dariusur/SpectrumAnalyzer/SpectrumAnalyzer/SpectrumAnalyzer.runs/impl_1/.init_design.begin.rst

<?xml version="1.0"?>
<ProcessHandle Version="1" Minor="0">
    <Process Command=".planAhead." Owner="Darius" Host="DESKTOP-7B2FBLM" Pid="12524">
    </Process>
</ProcessHandle>
