dariusur/SpectrumAnalyzer/SpectrumAnalyzer/SpectrumAnalyzer.runs/dft_0_synth_1/.vivado.begin.rst

<?xml version="1.0"?>
<ProcessHandle Version="1" Minor="0">
    <Process Command="vivado.bat" Owner="Darius" Host="DESKTOP-7B2FBLM" Pid="7576" HostCore="16" HostMemory="014877265920">
    </Process>
</ProcessHandle>
