dariusur/SpectrumAnalyzer/SpectrumAnalyzer/SpectrumAnalyzer.gen/sources_1/ip/dft_0/doc/dft_v4_2_changelog.txt

2022.2:
 * Version 4.2 (Rev. 3)
 * No changes

2022.1.2:
 * Version 4.2 (Rev. 3)
 * No changes

2022.1.1:
 * Version 4.2 (Rev. 3)
 * No changes

2022.1:
 * Version 4.2 (Rev. 3)
 * General: Matlab demonstration smoke test updated. No change to core functionality.
 * General: changing RTL defaults to ensure faithful regeneration from XCI

2021.2.2:
 * Version 4.2 (Rev. 2)
 * No changes

2021.2.1:
 * Version 4.2 (Rev. 2)
 * No changes

2021.2:
 * Version 4.2 (Rev. 2)
 * No changes

2021.1.1:
 * Version 4.2 (Rev. 2)
 * No changes

2021.1:
 * Version 4.2 (Rev. 2)
 * Bug Fix: Fix power-on edge case
 * Bug Fix: Fix stale c model file causing issues in shared object file

2020.3:
 * Version 4.2 (Rev. 1)
 * No changes

2020.2.2:
 * Version 4.2 (Rev. 1)
 * No changes

2020.2.1:
 * Version 4.2 (Rev. 1)
 * No changes

2020.2:
 * Version 4.2 (Rev. 1)
 * Bug Fix: MEX wrapper did not support new point sizes.

2020.1.1:
 * Version 4.2
 * No changes

2020.1:
 * Version 4.2
 * General: Support added for larger point sizes 1440, 1500, 1620, 1728, 1800, 1920, 1944, 2160, 2304, 2400, 2592, 2700, 2880, 2916, 3000, 3072, 3240

2019.2.2:
 * Version 4.1 (Rev. 1)
 * No changes

2019.2.1:
 * Version 4.1 (Rev. 1)
 * No changes

2019.2:
 * Version 4.1 (Rev. 1)
 * No changes

2019.1.3:
 * Version 4.1 (Rev. 1)
 * No changes

2019.1.2:
 * Version 4.1 (Rev. 1)
 * No changes

2019.1.1:
 * Version 4.1 (Rev. 1)
 * No changes

2019.1:
 * Version 4.1 (Rev. 1)
 * Revision change in one or more subcores

2018.3.1:
 * Version 4.1
 * No changes

2018.3:
 * Version 4.1
 * General: Support added for point sizes 4, 8, 16, 20, 32, 40, 64, 80, 128, 256

2018.2:
 * Version 4.0 (Rev. 15)
 * No changes

2018.1:
 * Version 4.0 (Rev. 15)
 * Revision change in one or more subcores

2017.4:
 * Version 4.0 (Rev. 14)
 * No changes

2017.3:
 * Version 4.0 (Rev. 14)
 * General: Comment change in C model. No change to functionality
 * Revision change in one or more subcores

2017.2:
 * Version 4.0 (Rev. 13)
 * No changes

2017.1:
 * Version 4.0 (Rev. 13)
 * Worked around LSB mismatch for point sizes 768 and 1080 between C model and IP seen when simulating with Vivado Simulator or Cadence IES
 * Fixed bug in Matlab MEX wrapper which prevented simulation of 1536-point DFT

2016.4:
 * Version 4.0 (Rev. 12)
 * No changes

2016.3:
 * Version 4.0 (Rev. 12)
 * General: Support for Spartan7 devices
 * Revision change in one or more subcores

2016.2:
 * Version 4.0 (Rev. 11)
 * No changes

2016.1:
 * Version 4.0 (Rev. 11)
 * Fix in common c model utilities package for handling of arrays of real types in Matlab
 * Revision change in one or more subcores

2015.4.2:
 * Version 4.0 (Rev. 10)
 * No changes

2015.4.1:
 * Version 4.0 (Rev. 10)
 * No changes

2015.4:
 * Version 4.0 (Rev. 10)
 * Revision change in one or more subcores

2015.3:
 * Version 4.0 (Rev. 9)
 * IP revision number added to HDL module, library, and include file names, to support designs with both locked and upgraded IP instances
 * Worked around LSB mismatch between C model and IP seen when simulating with Vivado Simulator or Cadence IES
 * Revision change in one or more subcores

2015.2.1:
 * Version 4.0 (Rev. 8)
 * No changes

2015.2:
 * Version 4.0 (Rev. 8)
 * Re-phrased internal function to avoid Vivado Simulator elaboration error.  No functional changes.

2015.1:
 * Version 4.0 (Rev. 7)
 * Addition of Beta support for future devices
 * Supported devices and production status are now determined automatically, to simplify support for future devices
 * C models are no longer provided for 32-bit operating systems as Vivado has deprecated 32-bit OS support

2014.4.1:
 * Version 4.0 (Rev. 6)
 * No changes

2014.4:
 * Version 4.0 (Rev. 6)
 * Encrypted source files are concatenated together to reduce the number of files and to reduce simulator compile time
 * Enabled out-of-context clock frequency setting by adding FREQ_HZ parameter to clock interface aclk_intf

2014.3:
 * Version 4.0 (Rev. 5)
 * Reduce memory consumption of C model.

2014.2:
 * Version 4.0 (Rev. 4)
 * No changes

2014.1:
 * Version 4.0 (Rev. 4)
 * C models for Windows are compiled using Microsoft Visual Studio 2012
 * Support for obsolete Spartan devices removed from source code. Functionality of is unaffected.
 * Rephrasing of vhdl files. Functionality is unaffected.
 * Internal device family name change, no functional changes
 * Enable third party synthesis tools to read encrypted netlists (but not source HDL)
 * Support for Virtex Ultrascale devices at Pre-Production Status

2013.4:
 * Version 4.0 (Rev. 3)
 * Support for Kintex Ultrascale devices at Pre-Production Status

2013.3:
 * Version 4.0 (Rev. 2)
 * Internal standardization in source file delivery, does not change behavior
 * Support for Automotive Artix-7, Automotive Zynq, Defense Grade Artix-7, Defense Grade Zynq and Lower Power Artix-7 devices at Production Status
 * Added default constraints for out of context flow
 * Added support for IP Integrator
 * Added support for Cadence IES and Synopsys VCS simulators
 * Removed C model dependency on stlport (STL Portability) library; C model now uses STL built into the compiler
 * Windows C model DLLs are statically linked to the Windows C run-time (CRT) library, to remove the runtime dependency on MSVCRT90.dll, which can cause problems when using the C model in a Windows compiler other than Visual Studio 2008

2013.2:
 * Version 4.0 (Rev. 1)
 * Support for Series 7 devices at Production status
 * Minor HDL changes to resolve compilation problem when using Cadence Incisive simulator.  No functional change.
 * Beta support for future devices
 * Removing support for Defense Grade Low Power Artix7

2013.1:
 * Version 4.0
 * Native Vivado Release
 * Changed all port names to upper case
 * There have been no functional changes to this IP.  The version number has changed to support unique versioning in Vivado starting with 2013.1.

(c) Copyright 2005 - 2022 Xilinx, Inc. All rights reserved.

This file contains confidential and proprietary information
of Xilinx, Inc. and is protected under U.S. and
international copyright and other intellectual property
laws.

DISCLAIMER
This disclaimer is not a license and does not grant any
rights to the materials distributed herewith. Except as
otherwise provided in a valid license issued to you by
Xilinx, and to the maximum extent permitted by applicable
law: (1) THESE MATERIALS ARE MADE AVAILABLE "AS IS" AND
WITH ALL FAULTS, AND XILINX HEREBY DISCLAIMS ALL WARRANTIES
AND CONDITIONS, EXPRESS, IMPLIED, OR STATUTORY, INCLUDING
BUT NOT LIMITED TO WARRANTIES OF MERCHANTABILITY, NON-
INFRINGEMENT, OR FITNESS FOR ANY PARTICULAR PURPOSE; and
(2) Xilinx shall not be liable (whether in contract or tort,
including negligence, or under any other theory of
liability) for any loss or damage of any kind or nature
related to, arising under or in connection with these
materials, including for any direct, or any indirect,
special, incidental, or consequential loss or damage
(including loss of data, profits, goodwill, or any type of
loss or damage suffered as a result of any action brought
by a third party) even if such damage or loss was
reasonably foreseeable or Xilinx had been advised of the
possibility of the same.

CRITICAL APPLICATIONS
Xilinx products are not designed or intended to be fail-
safe, or for use in any application requiring fail-safe
performance, such as life-support or safety devices or
systems, Class III medical devices, nuclear facilities,
applications related to the deployment of airbags, or any
other applications that could lead to death, personal
injury, or severe property or environmental damage
(individually and collectively, "Critical
Applications"). Customer assumes the sole risk and
liability of any use of Xilinx products in Critical
Applications, subject only to applicable laws and
regulations governing limitations on product liability.

THIS COPYRIGHT NOTICE AND DISCLAIMER MUST BE RETAINED AS
PART OF THIS FILE AT ALL TIMES.
