dariusur/SpectrumAnalyzer/SpectrumAnalyzer/SpectrumAnalyzer.runs/synth_1/.Xil/TOP_propImpl.xdc

set_property SRC_FILE_INFO {cfile:C:/Users/Darius/Desktop/coding_stuff/projects_for_resume/SpectrumAnalyzer/SpectrumAnalyzer/SpectrumAnalyzer.srcs/constrs_1/imports/digilent-xdc-master/Arty-A7-35-Master.xdc rfile:../../../SpectrumAnalyzer.srcs/constrs_1/imports/digilent-xdc-master/Arty-A7-35-Master.xdc id:1} [current_design]
set_property src_info {type:XDC file:1 line:11 export:INPUT save:INPUT read:READ} [current_design]
set_property -dict { PACKAGE_PIN E3    IOSTANDARD LVCMOS33 } [get_ports { clk }]; #IO_L12P_T1_MRCC_35 Sch=gclk[100]
set_property src_info {type:XDC file:1 line:41 export:INPUT save:INPUT read:READ} [current_design]
set_property -dict { PACKAGE_PIN D9    IOSTANDARD LVCMOS33 } [get_ports { reset_btn }]; #IO_L6N_T0_VREF_16 Sch=btn[0]
set_property src_info {type:XDC file:1 line:42 export:INPUT save:INPUT read:READ} [current_design]
set_property -dict { PACKAGE_PIN C9    IOSTANDARD LVCMOS33 } [get_ports { start_btn }]; #IO_L11P_T1_SRCC_16 Sch=btn[1]
set_property src_info {type:XDC file:1 line:87 export:INPUT save:INPUT read:READ} [current_design]
set_property -dict { PACKAGE_PIN D10   IOSTANDARD LVCMOS33 } [get_ports { uart_rxd_out }]; #IO_L19N_T3_VREF_16 Sch=uart_rxd_out  ARTY -> PC
set_property src_info {type:XDC file:1 line:130 export:INPUT save:INPUT read:READ} [current_design]
set_property -dict { PACKAGE_PIN A5    IOSTANDARD LVCMOS33 } [get_ports { vaux5_n  }]; #IO_L3N_T0_DQS_AD5N_35 	Sch=ck_an_n[1]	ChipKit pin=A1
set_property src_info {type:XDC file:1 line:131 export:INPUT save:INPUT read:READ} [current_design]
set_property -dict { PACKAGE_PIN A6    IOSTANDARD LVCMOS33 } [get_ports { vaux5_p  }]; #IO_L3P_T0_DQS_AD5P_35 	Sch=ck_an_p[1]	ChipKit pin=A1
