dariusur/SpectrumAnalyzer/SpectrumAnalyzer/SpectrumAnalyzer.gen/sources_1/ip/cordic_0/cordic_0_stub.v

// Copyright 1986-2022 Xilinx, Inc. All Rights Reserved.
// --------------------------------------------------------------------------------
// Tool Version: Vivado v.2022.2 (win64) Build 3671981 Fri Oct 14 05:00:03 MDT 2022
// Date        : Wed Jan 10 11:54:10 2024
// Host        : DESKTOP-7B2FBLM running 64-bit major release  (build 9200)
// Command     : write_verilog -force -mode synth_stub
//               c:/Users/Darius/Desktop/coding_stuff/projects_for_resume/SpectrumAnalyzer/Vivado/DFT_TEST_3/DFT_TEST_3.gen/sources_1/ip/cordic_0/cordic_0_stub.v
// Design      : cordic_0
// Purpose     : Stub declaration of top-level module interface
// Device      : xc7a35ticsg324-1L
// --------------------------------------------------------------------------------

// This empty module with port declaration file causes synthesis tools to infer a black box for IP.
// The synthesis directives are for Synopsys Synplify support to prevent IO buffer insertion.
// Please paste the declaration into a Verilog source file or add the file as an additional source.
(* x_core_info = "cordic_v6_0_18,Vivado 2022.2" *)
module cordic_0(aclk, s_axis_cartesian_tvalid, 
  s_axis_cartesian_tdata, m_axis_dout_tvalid, m_axis_dout_tdata)
/* synthesis syn_black_box black_box_pad_pin="aclk,s_axis_cartesian_tvalid,s_axis_cartesian_tdata[23:0],m_axis_dout_tvalid,m_axis_dout_tdata[23:0]" */;
  input aclk;
  input s_axis_cartesian_tvalid;
  input [23:0]s_axis_cartesian_tdata;
  output m_axis_dout_tvalid;
  output [23:0]m_axis_dout_tdata;
endmodule
