dariusur/SpectrumAnalyzer/SpectrumAnalyzer/SpectrumAnalyzer.gen/sources_1/ip/debouncer_0/debouncer_0_stub.vhdl

-- Copyright 1986-2022 Xilinx, Inc. All Rights Reserved.
-- --------------------------------------------------------------------------------
-- Tool Version: Vivado v.2022.2 (win64) Build 3671981 Fri Oct 14 05:00:03 MDT 2022
-- Date        : Fri Jan 12 10:39:07 2024
-- Host        : DESKTOP-7B2FBLM running 64-bit major release  (build 9200)
-- Command     : write_vhdl -force -mode synth_stub -rename_top debouncer_0 -prefix
--               debouncer_0_ debouncer_0_stub.vhdl
-- Design      : debouncer_0
-- Purpose     : Stub declaration of top-level module interface
-- Device      : xc7a35ticsg324-1L
-- --------------------------------------------------------------------------------
library IEEE;
use IEEE.STD_LOGIC_1164.ALL;

entity debouncer_0 is
  Port ( 
    clk : in STD_LOGIC;
    btn_in : in STD_LOGIC;
    btn_out : out STD_LOGIC
  );

end debouncer_0;

architecture stub of debouncer_0 is
attribute syn_black_box : boolean;
attribute black_box_pad_pin : string;
attribute syn_black_box of stub : architecture is true;
attribute black_box_pad_pin of stub : architecture is "clk,btn_in,btn_out";
attribute X_CORE_INFO : string;
attribute X_CORE_INFO of stub : architecture is "debouncer,Vivado 2022.2";
begin
end;
