dariusur/SpectrumAnalyzer/SpectrumAnalyzer/SpectrumAnalyzer.gen/sources_1/ip/xadc_wiz_0/xadc_wiz_0_stub.vhdl

-- Copyright 1986-2022 Xilinx, Inc. All Rights Reserved.
-- --------------------------------------------------------------------------------
-- Tool Version: Vivado v.2022.2 (win64) Build 3671981 Fri Oct 14 05:00:03 MDT 2022
-- Date        : Thu Jan 11 09:21:21 2024
-- Host        : DESKTOP-7B2FBLM running 64-bit major release  (build 9200)
-- Command     : write_vhdl -force -mode synth_stub
--               c:/Users/Darius/Desktop/coding_stuff/projects_for_resume/SpectrumAnalyzer/Vivado/DFT_TEST_4/DFT_TEST_4.gen/sources_1/ip/xadc_wiz_0/xadc_wiz_0_stub.vhdl
-- Design      : xadc_wiz_0
-- Purpose     : Stub declaration of top-level module interface
-- Device      : xc7a35ticsg324-1L
-- --------------------------------------------------------------------------------
library IEEE;
use IEEE.STD_LOGIC_1164.ALL;

entity xadc_wiz_0 is
  Port ( 
    daddr_in : in STD_LOGIC_VECTOR ( 6 downto 0 );
    dclk_in : in STD_LOGIC;
    den_in : in STD_LOGIC;
    di_in : in STD_LOGIC_VECTOR ( 15 downto 0 );
    dwe_in : in STD_LOGIC;
    reset_in : in STD_LOGIC;
    vauxp5 : in STD_LOGIC;
    vauxn5 : in STD_LOGIC;
    busy_out : out STD_LOGIC;
    channel_out : out STD_LOGIC_VECTOR ( 4 downto 0 );
    do_out : out STD_LOGIC_VECTOR ( 15 downto 0 );
    drdy_out : out STD_LOGIC;
    eoc_out : out STD_LOGIC;
    eos_out : out STD_LOGIC;
    ot_out : out STD_LOGIC;
    vccaux_alarm_out : out STD_LOGIC;
    vccint_alarm_out : out STD_LOGIC;
    user_temp_alarm_out : out STD_LOGIC;
    alarm_out : out STD_LOGIC;
    vp_in : in STD_LOGIC;
    vn_in : in STD_LOGIC
  );

end xadc_wiz_0;

architecture stub of xadc_wiz_0 is
attribute syn_black_box : boolean;
attribute black_box_pad_pin : string;
attribute syn_black_box of stub : architecture is true;
attribute black_box_pad_pin of stub : architecture is "daddr_in[6:0],dclk_in,den_in,di_in[15:0],dwe_in,reset_in,vauxp5,vauxn5,busy_out,channel_out[4:0],do_out[15:0],drdy_out,eoc_out,eos_out,ot_out,vccaux_alarm_out,vccint_alarm_out,user_temp_alarm_out,alarm_out,vp_in,vn_in";
begin
end;
