dariusur/SpectrumAnalyzer/SpectrumAnalyzer/SpectrumAnalyzer.gen/sources_1/ip/debouncer_0/debouncer_0_sim_netlist.v

// Copyright 1986-2022 Xilinx, Inc. All Rights Reserved.
// --------------------------------------------------------------------------------
// Tool Version: Vivado v.2022.2 (win64) Build 3671981 Fri Oct 14 05:00:03 MDT 2022
// Date        : Fri Jan 12 10:39:07 2024
// Host        : DESKTOP-7B2FBLM running 64-bit major release  (build 9200)
// Command     : write_verilog -force -mode funcsim -rename_top debouncer_0 -prefix
//               debouncer_0_ debouncer_0_sim_netlist.v
// Design      : debouncer_0
// Purpose     : This verilog netlist is a functional simulation representation of the design and should not be modified
//               or synthesized. This netlist cannot be used for SDF annotated simulation.
// Device      : xc7a35ticsg324-1L
// --------------------------------------------------------------------------------
`timescale 1 ps / 1 ps

module debouncer_0_debouncer
   (btn_out,
    clk,
    btn_in);
  output btn_out;
  input clk;
  input btn_in;

  wire btn_in;
  wire btn_out;
  wire btn_out_i_1_n_0;
  wire btn_out_i_2_n_0;
  wire btn_out_i_3_n_0;
  wire btn_out_i_4_n_0;
  wire btn_out_i_5_n_0;
  wire btn_out_i_6_n_0;
  wire btn_out_i_7_n_0;
  wire btn_out_i_8_n_0;
  wire btn_state;
  wire clk;
  wire counter;
  wire \counter[0]_i_10_n_0 ;
  wire \counter[0]_i_1_n_0 ;
  wire \counter[0]_i_4_n_0 ;
  wire \counter[0]_i_5_n_0 ;
  wire \counter[0]_i_6_n_0 ;
  wire \counter[0]_i_7_n_0 ;
  wire \counter[0]_i_8_n_0 ;
  wire \counter[0]_i_9_n_0 ;
  wire [31:0]counter_reg;
  wire \counter_reg[0]_i_3_n_0 ;
  wire \counter_reg[0]_i_3_n_1 ;
  wire \counter_reg[0]_i_3_n_2 ;
  wire \counter_reg[0]_i_3_n_3 ;
  wire \counter_reg[0]_i_3_n_4 ;
  wire \counter_reg[0]_i_3_n_5 ;
  wire \counter_reg[0]_i_3_n_6 ;
  wire \counter_reg[0]_i_3_n_7 ;
  wire \counter_reg[12]_i_1_n_0 ;
  wire \counter_reg[12]_i_1_n_1 ;
  wire \counter_reg[12]_i_1_n_2 ;
  wire \counter_reg[12]_i_1_n_3 ;
  wire \counter_reg[12]_i_1_n_4 ;
  wire \counter_reg[12]_i_1_n_5 ;
  wire \counter_reg[12]_i_1_n_6 ;
  wire \counter_reg[12]_i_1_n_7 ;
  wire \counter_reg[16]_i_1_n_0 ;
  wire \counter_reg[16]_i_1_n_1 ;
  wire \counter_reg[16]_i_1_n_2 ;
  wire \counter_reg[16]_i_1_n_3 ;
  wire \counter_reg[16]_i_1_n_4 ;
  wire \counter_reg[16]_i_1_n_5 ;
  wire \counter_reg[16]_i_1_n_6 ;
  wire \counter_reg[16]_i_1_n_7 ;
  wire \counter_reg[20]_i_1_n_0 ;
  wire \counter_reg[20]_i_1_n_1 ;
  wire \counter_reg[20]_i_1_n_2 ;
  wire \counter_reg[20]_i_1_n_3 ;
  wire \counter_reg[20]_i_1_n_4 ;
  wire \counter_reg[20]_i_1_n_5 ;
  wire \counter_reg[20]_i_1_n_6 ;
  wire \counter_reg[20]_i_1_n_7 ;
  wire \counter_reg[24]_i_1_n_0 ;
  wire \counter_reg[24]_i_1_n_1 ;
  wire \counter_reg[24]_i_1_n_2 ;
  wire \counter_reg[24]_i_1_n_3 ;
  wire \counter_reg[24]_i_1_n_4 ;
  wire \counter_reg[24]_i_1_n_5 ;
  wire \counter_reg[24]_i_1_n_6 ;
  wire \counter_reg[24]_i_1_n_7 ;
  wire \counter_reg[28]_i_1_n_1 ;
  wire \counter_reg[28]_i_1_n_2 ;
  wire \counter_reg[28]_i_1_n_3 ;
  wire \counter_reg[28]_i_1_n_4 ;
  wire \counter_reg[28]_i_1_n_5 ;
  wire \counter_reg[28]_i_1_n_6 ;
  wire \counter_reg[28]_i_1_n_7 ;
  wire \counter_reg[4]_i_1_n_0 ;
  wire \counter_reg[4]_i_1_n_1 ;
  wire \counter_reg[4]_i_1_n_2 ;
  wire \counter_reg[4]_i_1_n_3 ;
  wire \counter_reg[4]_i_1_n_4 ;
  wire \counter_reg[4]_i_1_n_5 ;
  wire \counter_reg[4]_i_1_n_6 ;
  wire \counter_reg[4]_i_1_n_7 ;
  wire \counter_reg[8]_i_1_n_0 ;
  wire \counter_reg[8]_i_1_n_1 ;
  wire \counter_reg[8]_i_1_n_2 ;
  wire \counter_reg[8]_i_1_n_3 ;
  wire \counter_reg[8]_i_1_n_4 ;
  wire \counter_reg[8]_i_1_n_5 ;
  wire \counter_reg[8]_i_1_n_6 ;
  wire \counter_reg[8]_i_1_n_7 ;
  wire [3:3]\NLW_counter_reg[28]_i_1_CO_UNCONNECTED ;

  LUT5 #(
    .INIT(32'hBFFF8000)) 
    btn_out_i_1
       (.I0(btn_state),
        .I1(btn_out_i_2_n_0),
        .I2(btn_out_i_3_n_0),
        .I3(btn_out_i_4_n_0),
        .I4(btn_out),
        .O(btn_out_i_1_n_0));
  LUT6 #(
    .INIT(64'h0000000000000002)) 
    btn_out_i_2
       (.I0(counter_reg[22]),
        .I1(counter_reg[23]),
        .I2(counter_reg[20]),
        .I3(counter_reg[21]),
        .I4(counter_reg[25]),
        .I5(counter_reg[24]),
        .O(btn_out_i_2_n_0));
  LUT6 #(
    .INIT(64'h0000000000000001)) 
    btn_out_i_3
       (.I0(counter_reg[28]),
        .I1(counter_reg[29]),
        .I2(counter_reg[26]),
        .I3(counter_reg[27]),
        .I4(counter_reg[31]),
        .I5(counter_reg[30]),
        .O(btn_out_i_3_n_0));
  LUT6 #(
    .INIT(64'h0000008000000000)) 
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
        .CE(counter),
        .D(\counter_reg[28]_i_1_n_4 ),
        .Q(counter_reg[31]),
        .R(\counter[0]_i_1_n_0 ));
  FDRE \counter_reg[3] 
       (.C(clk),
        .CE(counter),
        .D(\counter_reg[0]_i_3_n_4 ),
        .Q(counter_reg[3]),
        .R(\counter[0]_i_1_n_0 ));
  FDRE \counter_reg[4] 
       (.C(clk),
        .CE(counter),
        .D(\counter_reg[4]_i_1_n_7 ),
        .Q(counter_reg[4]),
        .R(\counter[0]_i_1_n_0 ));
  (* ADDER_THRESHOLD = "11" *) 
  CARRY4 \counter_reg[4]_i_1 
       (.CI(\counter_reg[0]_i_3_n_0 ),
        .CO({\counter_reg[4]_i_1_n_0 ,\counter_reg[4]_i_1_n_1 ,\counter_reg[4]_i_1_n_2 ,\counter_reg[4]_i_1_n_3 }),
        .CYINIT(1'b0),
        .DI({1'b0,1'b0,1'b0,1'b0}),
        .O({\counter_reg[4]_i_1_n_4 ,\counter_reg[4]_i_1_n_5 ,\counter_reg[4]_i_1_n_6 ,\counter_reg[4]_i_1_n_7 }),
        .S(counter_reg[7:4]));
  FDRE \counter_reg[5] 
       (.C(clk),
        .CE(counter),
        .D(\counter_reg[4]_i_1_n_6 ),
        .Q(counter_reg[5]),
        .R(\counter[0]_i_1_n_0 ));
  FDRE \counter_reg[6] 
       (.C(clk),
        .CE(counter),
        .D(\counter_reg[4]_i_1_n_5 ),
        .Q(counter_reg[6]),
        .R(\counter[0]_i_1_n_0 ));
  FDRE \counter_reg[7] 
       (.C(clk),
        .CE(counter),
        .D(\counter_reg[4]_i_1_n_4 ),
        .Q(counter_reg[7]),
        .R(\counter[0]_i_1_n_0 ));
  FDRE \counter_reg[8] 
       (.C(clk),
        .CE(counter),
        .D(\counter_reg[8]_i_1_n_7 ),
        .Q(counter_reg[8]),
        .R(\counter[0]_i_1_n_0 ));
  (* ADDER_THRESHOLD = "11" *) 
  CARRY4 \counter_reg[8]_i_1 
       (.CI(\counter_reg[4]_i_1_n_0 ),
        .CO({\counter_reg[8]_i_1_n_0 ,\counter_reg[8]_i_1_n_1 ,\counter_reg[8]_i_1_n_2 ,\counter_reg[8]_i_1_n_3 }),
        .CYINIT(1'b0),
        .DI({1'b0,1'b0,1'b0,1'b0}),
        .O({\counter_reg[8]_i_1_n_4 ,\counter_reg[8]_i_1_n_5 ,\counter_reg[8]_i_1_n_6 ,\counter_reg[8]_i_1_n_7 }),
        .S(counter_reg[11:8]));
  FDRE \counter_reg[9] 
       (.C(clk),
        .CE(counter),
        .D(\counter_reg[8]_i_1_n_6 ),
        .Q(counter_reg[9]),
        .R(\counter[0]_i_1_n_0 ));
endmodule

(* CHECK_LICENSE_TYPE = "debouncer_0,debouncer,{}" *) (* DowngradeIPIdentifiedWarnings = "yes" *) (* IP_DEFINITION_SOURCE = "package_project" *) 
(* X_CORE_INFO = "debouncer,Vivado 2022.2" *) 
(* NotValidForBitStream *)
module debouncer_0
   (clk,
    btn_in,
    btn_out);
  (* X_INTERFACE_INFO = "xilinx.com:signal:clock:1.0 clk CLK" *) (* X_INTERFACE_PARAMETER = "XIL_INTERFACENAME clk, ASSOCIATED_RESET reset, FREQ_HZ 100000000, FREQ_TOLERANCE_HZ 0, PHASE 0.0, INSERT_VIP 0" *) input clk;
  input btn_in;
  output btn_out;

  wire btn_in;
  wire btn_out;
  wire clk;

  debouncer_0_debouncer inst
       (.btn_in(btn_in),
        .btn_out(btn_out),
        .clk(clk));
endmodule
`ifndef GLBL
`define GLBL
`timescale  1 ps / 1 ps

module glbl ();

    parameter ROC_WIDTH = 100000;
    parameter TOC_WIDTH = 0;
    parameter GRES_WIDTH = 10000;
    parameter GRES_START = 10000;

//--------   STARTUP Globals --------------
    wire GSR;
    wire GTS;
    wire GWE;
    wire PRLD;
    wire GRESTORE;
    tri1 p_up_tmp;
    tri (weak1, strong0) PLL_LOCKG = p_up_tmp;

    wire PROGB_GLBL;
    wire CCLKO_GLBL;
    wire FCSBO_GLBL;
    wire [3:0] DO_GLBL;
    wire [3:0] DI_GLBL;
   
    reg GSR_int;
    reg GTS_int;
    reg PRLD_int;
    reg GRESTORE_int;

//--------   JTAG Globals --------------
    wire JTAG_TDO_GLBL;
    wire JTAG_TCK_GLBL;
    wire JTAG_TDI_GLBL;
    wire JTAG_TMS_GLBL;
    wire JTAG_TRST_GLBL;

    reg JTAG_CAPTURE_GLBL;
    reg JTAG_RESET_GLBL;
    reg JTAG_SHIFT_GLBL;
    reg JTAG_UPDATE_GLBL;
    reg JTAG_RUNTEST_GLBL;

    reg JTAG_SEL1_GLBL = 0;
    reg JTAG_SEL2_GLBL = 0 ;
    reg JTAG_SEL3_GLBL = 0;
    reg JTAG_SEL4_GLBL = 0;

    reg JTAG_USER_TDO1_GLBL = 1'bz;
    reg JTAG_USER_TDO2_GLBL = 1'bz;
    reg JTAG_USER_TDO3_GLBL = 1'bz;
    reg JTAG_USER_TDO4_GLBL = 1'bz;

    assign (strong1, weak0) GSR = GSR_int;
    assign (strong1, weak0) GTS = GTS_int;
    assign (weak1, weak0) PRLD = PRLD_int;
    assign (strong1, weak0) GRESTORE = GRESTORE_int;

    initial begin
	GSR_int = 1'b1;
	PRLD_int = 1'b1;
	#(ROC_WIDTH)
	GSR_int = 1'b0;
	PRLD_int = 1'b0;
    end

    initial begin
	GTS_int = 1'b1;
	#(TOC_WIDTH)
	GTS_int = 1'b0;
    end

    initial begin 
	GRESTORE_int = 1'b0;
	#(GRES_START);
	GRESTORE_int = 1'b1;
	#(GRES_WIDTH);
	GRESTORE_int = 1'b0;
    end

endmodule
`endif
