dariusur/SpectrumAnalyzer/SpectrumAnalyzer/SpectrumAnalyzer.gen/sources_1/ip/debouncer_0/debouncer_0_sim_netlist.vhdl

-- Copyright 1986-2022 Xilinx, Inc. All Rights Reserved.
-- --------------------------------------------------------------------------------
-- Tool Version: Vivado v.2022.2 (win64) Build 3671981 Fri Oct 14 05:00:03 MDT 2022
-- Date        : Fri Jan 12 10:39:07 2024
-- Host        : DESKTOP-7B2FBLM running 64-bit major release  (build 9200)
-- Command     : write_vhdl -force -mode funcsim -rename_top debouncer_0 -prefix
--               debouncer_0_ debouncer_0_sim_netlist.vhdl
-- Design      : debouncer_0
-- Purpose     : This VHDL netlist is a functional simulation representation of the design and should not be modified or
--               synthesized. This netlist cannot be used for SDF annotated simulation.
-- Device      : xc7a35ticsg324-1L
-- --------------------------------------------------------------------------------
library IEEE;
use IEEE.STD_LOGIC_1164.ALL;
library UNISIM;
use UNISIM.VCOMPONENTS.ALL;
entity debouncer_0_debouncer is
  port (
    btn_out : out STD_LOGIC;
    clk : in STD_LOGIC;
    btn_in : in STD_LOGIC
  );
end debouncer_0_debouncer;

architecture STRUCTURE of debouncer_0_debouncer is
  signal \^btn_out\ : STD_LOGIC;
  signal btn_out_i_1_n_0 : STD_LOGIC;
  signal btn_out_i_2_n_0 : STD_LOGIC;
  signal btn_out_i_3_n_0 : STD_LOGIC;
  signal btn_out_i_4_n_0 : STD_LOGIC;
  signal btn_out_i_5_n_0 : STD_LOGIC;
  signal btn_out_i_6_n_0 : STD_LOGIC;
  signal btn_out_i_7_n_0 : STD_LOGIC;
  signal btn_out_i_8_n_0 : STD_LOGIC;
  signal btn_state : STD_LOGIC;
  signal counter : STD_LOGIC;
  signal \counter[0]_i_10_n_0\ : STD_LOGIC;
  signal \counter[0]_i_1_n_0\ : STD_LOGIC;
  signal \counter[0]_i_4_n_0\ : STD_LOGIC;
  signal \counter[0]_i_5_n_0\ : STD_LOGIC;
  signal \counter[0]_i_6_n_0\ : STD_LOGIC;
  signal \counter[0]_i_7_n_0\ : STD_LOGIC;
  signal \counter[0]_i_8_n_0\ : STD_LOGIC;
  signal \counter[0]_i_9_n_0\ : STD_LOGIC;
  signal counter_reg : STD_LOGIC_VECTOR ( 31 downto 0 );
  signal \counter_reg[0]_i_3_n_0\ : STD_LOGIC;
  signal \counter_reg[0]_i_3_n_1\ : STD_LOGIC;
  signal \counter_reg[0]_i_3_n_2\ : STD_LOGIC;
  signal \counter_reg[0]_i_3_n_3\ : STD_LOGIC;
  signal \counter_reg[0]_i_3_n_4\ : STD_LOGIC;
  signal \counter_reg[0]_i_3_n_5\ : STD_LOGIC;
  signal \counter_reg[0]_i_3_n_6\ : STD_LOGIC;
  signal \counter_reg[0]_i_3_n_7\ : STD_LOGIC;
  signal \counter_reg[12]_i_1_n_0\ : STD_LOGIC;
  signal \counter_reg[12]_i_1_n_1\ : STD_LOGIC;
  signal \counter_reg[12]_i_1_n_2\ : STD_LOGIC;
  signal \counter_reg[12]_i_1_n_3\ : STD_LOGIC;
  signal \counter_reg[12]_i_1_n_4\ : STD_LOGIC;
  signal \counter_reg[12]_i_1_n_5\ : STD_LOGIC;
  signal \counter_reg[12]_i_1_n_6\ : STD_LOGIC;
  signal \counter_reg[12]_i_1_n_7\ : STD_LOGIC;
  signal \counter_reg[16]_i_1_n_0\ : STD_LOGIC;
  signal \counter_reg[16]_i_1_n_1\ : STD_LOGIC;
  signal \counter_reg[16]_i_1_n_2\ : STD_LOGIC;
  signal \counter_reg[16]_i_1_n_3\ : STD_LOGIC;
  signal \counter_reg[16]_i_1_n_4\ : STD_LOGIC;
  signal \counter_reg[16]_i_1_n_5\ : STD_LOGIC;
  signal \counter_reg[16]_i_1_n_6\ : STD_LOGIC;
  signal \counter_reg[16]_i_1_n_7\ : STD_LOGIC;
  signal \counter_reg[20]_i_1_n_0\ : STD_LOGIC;
  signal \counter_reg[20]_i_1_n_1\ : STD_LOGIC;
  signal \counter_reg[20]_i_1_n_2\ : STD_LOGIC;
  signal \counter_reg[20]_i_1_n_3\ : STD_LOGIC;
  signal \counter_reg[20]_i_1_n_4\ : STD_LOGIC;
  signal \counter_reg[20]_i_1_n_5\ : STD_LOGIC;
  signal \counter_reg[20]_i_1_n_6\ : STD_LOGIC;
  signal \counter_reg[20]_i_1_n_7\ : STD_LOGIC;
  signal \counter_reg[24]_i_1_n_0\ : STD_LOGIC;
  signal \counter_reg[24]_i_1_n_1\ : STD_LOGIC;
  signal \counter_reg[24]_i_1_n_2\ : STD_LOGIC;
  signal \counter_reg[24]_i_1_n_3\ : STD_LOGIC;
  signal \counter_reg[24]_i_1_n_4\ : STD_LOGIC;
  signal \counter_reg[24]_i_1_n_5\ : STD_LOGIC;
  signal \counter_reg[24]_i_1_n_6\ : STD_LOGIC;
  signal \counter_reg[24]_i_1_n_7\ : STD_LOGIC;
  signal \counter_reg[28]_i_1_n_1\ : STD_LOGIC;
  signal \counter_reg[28]_i_1_n_2\ : STD_LOGIC;
  signal \counter_reg[28]_i_1_n_3\ : STD_LOGIC;
  signal \counter_reg[28]_i_1_n_4\ : STD_LOGIC;
  signal \counter_reg[28]_i_1_n_5\ : STD_LOGIC;
  signal \counter_reg[28]_i_1_n_6\ : STD_LOGIC;
  signal \counter_reg[28]_i_1_n_7\ : STD_LOGIC;
  signal \counter_reg[4]_i_1_n_0\ : STD_LOGIC;
  signal \counter_reg[4]_i_1_n_1\ : STD_LOGIC;
  signal \counter_reg[4]_i_1_n_2\ : STD_LOGIC;
  signal \counter_reg[4]_i_1_n_3\ : STD_LOGIC;
  signal \counter_reg[4]_i_1_n_4\ : STD_LOGIC;
  signal \counter_reg[4]_i_1_n_5\ : STD_LOGIC;
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
\counter_reg[7]\: unisim.vcomponents.FDRE
     port map (
      C => clk,
      CE => counter,
      D => \counter_reg[4]_i_1_n_4\,
      Q => counter_reg(7),
      R => \counter[0]_i_1_n_0\
    );
\counter_reg[8]\: unisim.vcomponents.FDRE
     port map (
      C => clk,
      CE => counter,
      D => \counter_reg[8]_i_1_n_7\,
      Q => counter_reg(8),
      R => \counter[0]_i_1_n_0\
    );
\counter_reg[8]_i_1\: unisim.vcomponents.CARRY4
     port map (
      CI => \counter_reg[4]_i_1_n_0\,
      CO(3) => \counter_reg[8]_i_1_n_0\,
      CO(2) => \counter_reg[8]_i_1_n_1\,
      CO(1) => \counter_reg[8]_i_1_n_2\,
      CO(0) => \counter_reg[8]_i_1_n_3\,
      CYINIT => '0',
      DI(3 downto 0) => B"0000",
      O(3) => \counter_reg[8]_i_1_n_4\,
      O(2) => \counter_reg[8]_i_1_n_5\,
      O(1) => \counter_reg[8]_i_1_n_6\,
      O(0) => \counter_reg[8]_i_1_n_7\,
      S(3 downto 0) => counter_reg(11 downto 8)
    );
\counter_reg[9]\: unisim.vcomponents.FDRE
     port map (
      C => clk,
      CE => counter,
      D => \counter_reg[8]_i_1_n_6\,
      Q => counter_reg(9),
      R => \counter[0]_i_1_n_0\
    );
end STRUCTURE;
library IEEE;
use IEEE.STD_LOGIC_1164.ALL;
library UNISIM;
use UNISIM.VCOMPONENTS.ALL;
entity debouncer_0 is
  port (
    clk : in STD_LOGIC;
    btn_in : in STD_LOGIC;
    btn_out : out STD_LOGIC
  );
  attribute NotValidForBitStream : boolean;
  attribute NotValidForBitStream of debouncer_0 : entity is true;
  attribute CHECK_LICENSE_TYPE : string;
  attribute CHECK_LICENSE_TYPE of debouncer_0 : entity is "debouncer_0,debouncer,{}";
  attribute DowngradeIPIdentifiedWarnings : string;
  attribute DowngradeIPIdentifiedWarnings of debouncer_0 : entity is "yes";
  attribute IP_DEFINITION_SOURCE : string;
  attribute IP_DEFINITION_SOURCE of debouncer_0 : entity is "package_project";
  attribute X_CORE_INFO : string;
  attribute X_CORE_INFO of debouncer_0 : entity is "debouncer,Vivado 2022.2";
end debouncer_0;

architecture STRUCTURE of debouncer_0 is
  attribute X_INTERFACE_INFO : string;
  attribute X_INTERFACE_INFO of clk : signal is "xilinx.com:signal:clock:1.0 clk CLK";
  attribute X_INTERFACE_PARAMETER : string;
  attribute X_INTERFACE_PARAMETER of clk : signal is "XIL_INTERFACENAME clk, ASSOCIATED_RESET reset, FREQ_HZ 100000000, FREQ_TOLERANCE_HZ 0, PHASE 0.0, INSERT_VIP 0";
begin
inst: entity work.debouncer_0_debouncer
     port map (
      btn_in => btn_in,
      btn_out => btn_out,
      clk => clk
    );
end STRUCTURE;
