dariusur/SpectrumAnalyzer/SpectrumAnalyzer/SpectrumAnalyzer.gen/sources_1/ip/xadc_wiz_0/xadc_wiz_0_sim_netlist.vhdl

-- Copyright 1986-2022 Xilinx, Inc. All Rights Reserved.
-- --------------------------------------------------------------------------------
-- Tool Version: Vivado v.2022.2 (win64) Build 3671981 Fri Oct 14 05:00:03 MDT 2022
-- Date        : Thu Jan 11 09:21:21 2024
-- Host        : DESKTOP-7B2FBLM running 64-bit major release  (build 9200)
-- Command     : write_vhdl -force -mode funcsim
--               c:/Users/Darius/Desktop/coding_stuff/projects_for_resume/SpectrumAnalyzer/Vivado/DFT_TEST_4/DFT_TEST_4.gen/sources_1/ip/xadc_wiz_0/xadc_wiz_0_sim_netlist.vhdl
-- Design      : xadc_wiz_0
-- Purpose     : This VHDL netlist is a functional simulation representation of the design and should not be modified or
--               synthesized. This netlist cannot be used for SDF annotated simulation.
-- Device      : xc7a35ticsg324-1L
-- --------------------------------------------------------------------------------
library IEEE;
use IEEE.STD_LOGIC_1164.ALL;
library UNISIM;
use UNISIM.VCOMPONENTS.ALL;
entity xadc_wiz_0 is
  port (
    daddr_in : in STD_LOGIC_VECTOR ( 6 downto 0 );
    dclk_in : in STD_LOGIC;
    den_in : in STD_LOGIC;
    di_in : in STD_LOGIC_VECTOR ( 15 downto 0 );
    dwe_in : in STD_LOGIC;
    reset_in : in STD_LOGIC;
    vauxp5 : in STD_LOGIC;
    vauxn5 : in STD_LOGIC;
    busy_out : out STD_LOGIC;
    channel_out : out STD_LOGIC_VECTOR ( 4 downto 0 );
    do_out : out STD_LOGIC_VECTOR ( 15 downto 0 );
    drdy_out : out STD_LOGIC;
    eoc_out : out STD_LOGIC;
    eos_out : out STD_LOGIC;
    ot_out : out STD_LOGIC;
    vccaux_alarm_out : out STD_LOGIC;
    vccint_alarm_out : out STD_LOGIC;
    user_temp_alarm_out : out STD_LOGIC;
    alarm_out : out STD_LOGIC;
    vp_in : in STD_LOGIC;
    vn_in : in STD_LOGIC
  );
  attribute NotValidForBitStream : boolean;
  attribute NotValidForBitStream of xadc_wiz_0 : entity is true;
end xadc_wiz_0;

architecture STRUCTURE of xadc_wiz_0 is
  signal NLW_inst_JTAGBUSY_UNCONNECTED : STD_LOGIC;
  signal NLW_inst_JTAGLOCKED_UNCONNECTED : STD_LOGIC;
  signal NLW_inst_JTAGMODIFIED_UNCONNECTED : STD_LOGIC;
  signal NLW_inst_ALM_UNCONNECTED : STD_LOGIC_VECTOR ( 6 downto 3 );
  signal NLW_inst_MUXADDR_UNCONNECTED : STD_LOGIC_VECTOR ( 4 downto 0 );
  attribute BOX_TYPE : string;
  attribute BOX_TYPE of inst : label is "PRIMITIVE";
begin
inst: unisim.vcomponents.XADC
    generic map(
      INIT_40 => X"0015",
      INIT_41 => X"31A0",
      INIT_42 => X"5700",
      INIT_43 => X"0000",
      INIT_44 => X"0000",
      INIT_45 => X"0000",
      INIT_46 => X"0000",
      INIT_47 => X"0000",
      INIT_48 => X"0100",
      INIT_49 => X"0000",
      INIT_4A => X"0000",
      INIT_4B => X"0000",
      INIT_4C => X"0000",
      INIT_4D => X"0000",
      INIT_4E => X"0000",
      INIT_4F => X"0000",
      INIT_50 => X"B5ED",
      INIT_51 => X"57E4",
      INIT_52 => X"A147",
      INIT_53 => X"CA33",
      INIT_54 => X"A93A",
      INIT_55 => X"52C6",
      INIT_56 => X"9555",
      INIT_57 => X"AE4E",
      INIT_58 => X"5999",
      INIT_59 => X"0000",
      INIT_5A => X"0000",
      INIT_5B => X"0000",
      INIT_5C => X"5111",
      INIT_5D => X"0000",
      INIT_5E => X"0000",
      INIT_5F => X"0000",
      IS_CONVSTCLK_INVERTED => '0',
      IS_DCLK_INVERTED => '0',
      SIM_DEVICE => "7SERIES",
      SIM_MONITOR_FILE => "design.txt"
    )
        port map (
      ALM(7) => alarm_out,
      ALM(6 downto 3) => NLW_inst_ALM_UNCONNECTED(6 downto 3),
      ALM(2) => vccaux_alarm_out,
      ALM(1) => vccint_alarm_out,
      ALM(0) => user_temp_alarm_out,
      BUSY => busy_out,
      CHANNEL(4 downto 0) => channel_out(4 downto 0),
      CONVST => '0',
      CONVSTCLK => '0',
      DADDR(6 downto 0) => daddr_in(6 downto 0),
      DCLK => dclk_in,
      DEN => den_in,
      DI(15 downto 0) => di_in(15 downto 0),
      DO(15 downto 0) => do_out(15 downto 0),
      DRDY => drdy_out,
      DWE => dwe_in,
      EOC => eoc_out,
      EOS => eos_out,
      JTAGBUSY => NLW_inst_JTAGBUSY_UNCONNECTED,
      JTAGLOCKED => NLW_inst_JTAGLOCKED_UNCONNECTED,
      JTAGMODIFIED => NLW_inst_JTAGMODIFIED_UNCONNECTED,
      MUXADDR(4 downto 0) => NLW_inst_MUXADDR_UNCONNECTED(4 downto 0),
      OT => ot_out,
      RESET => reset_in,
      VAUXN(15 downto 6) => B"0000000000",
      VAUXN(5) => vauxn5,
      VAUXN(4 downto 0) => B"00000",
      VAUXP(15 downto 6) => B"0000000000",
      VAUXP(5) => vauxp5,
      VAUXP(4 downto 0) => B"00000",
      VN => vn_in,
      VP => vp_in
    );
end STRUCTURE;
